gokselozgur5/ar-bot-jimmy/README.md

# Jimmy (`ar-bot-jimmy`) — 38 cm Modular Full-Body ROS 2 + AR Humanoid Companion

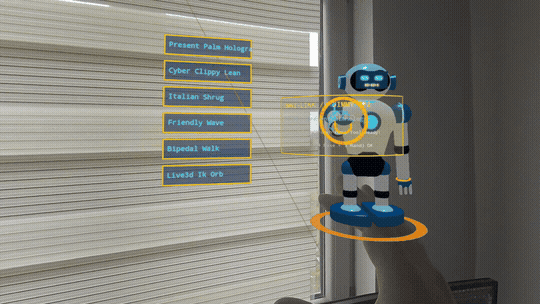
[picture p1: docs/media/quest3_passthrough_live.gif]
Meta Quest 3 Live Passthrough Demo


**Jimmy** is a 38 cm (1.5-span) desktop mini-humanoid companion robot combining **ROS 2 full-body 3-pivot kinematics**, **daisy-chain serial bus actuators**, an **Embodied LLM Puppeteer** (modern Cyber-Clippy persona), and an **OpenXR / Augmented Reality spatial hologram layer**.

## System Architecture

```mermaid
flowchart LR
    LLM["Embodied LLM Puppeteer"] -->|GestureIntent + GazeTarget3D| FK["3-Pivot Full-Body Kinematics"]
    FK -->|SyncWrite IDs 1..14| BUS["Daisy-Chain Serial Servo Bus"]
    BUS -->|Hot-Plug Wrist Socket IDs 15..20| HAND["Modular 3-Finger Hand"]
    FK -->|TF2: right_wrist_flange_link| AR["OpenXR / AR Palm Hologram"]
```

## Subsystem & Phase Matrix

| Phase | Subsystem | Core Artifact | Status |
| :--- | :--- | :--- | :--- |
| **Phase 1** | MBSE & 3-Pivot Kinematics | [`MBSE_MODEL.md`](docs/architecture/MBSE_MODEL.md), [`jimmy_full_body.urdf.xacro`](ros2/jimmy_description/urdf/jimmy_full_body.urdf.xacro), [`kinematics.rs`](crates/jimmy-core/src/kinematics.rs) | Verified |
| **Phase 2** | Serial Bus Servo Bridge | [`bus.rs`](crates/jimmy-core/src/bus.rs) (`ActuatorBus` trait & thermal guard) | Verified |
| **Phase 3** | Embodied LLM Puppeteer | [`puppeteer.rs`](crates/jimmy-core/src/puppeteer.rs) (`CyberClippyLean`, `PresentPalmHologram`) | Verified |
| **Phase 4** | OpenXR / AR Spatial Link | [`ar_anchor.rs`](crates/jimmy-core/src/ar_anchor.rs), [`web/index.html`](web/index.html) (Mass Effect Omni-HUD) | Verified |
| **Phase 5** | Modular 3-Finger Hand | [`hand.rs`](crates/jimmy-core/src/hand.rs) (`ThreeFingerHand` + compliant grasp torque limit) | Verified |
| **Phase 6** | Expressive Visor & 3D Fingers | [`visor-face.js`](web/visor-face.js), [`jimmy-model.js`](web/jimmy-model.js) (Blinking eyes & 3D phalanges) | Verified |
| **Phase 7** | 3-Pivot Inverse Kinematics | [`ik.rs`](crates/jimmy-core/src/ik.rs) (`solve_right_arm_ik` closed-form desk reach solver) | Verified |
| **Phase 8** | Quest 3 3D Laser & Holo-Menu | [`holo-menu.js`](web/holo-menu.js), [`xr-app.js`](web/xr-app.js) (3D spatial menu & controller raycaster) | Verified |
| **Phase 9** | Live LLM Chat & ROS 2 Bridge | [`llm-chat.js`](web/llm-chat.js), [`ros2_bridge.rs`](crates/jimmy-core/src/ros2_bridge.rs) (`Ros2JointState17` `/joint_states`) | Verified |
| **Phase 10** | Telemetry & Control Daemon | [`crates/jimmy-daemon/`](crates/jimmy-daemon/src/main.rs) (`127.0.0.1:8765` live JSON & IK endpoint) | Verified |
| **Phase 11** | Quest 3 Spatial Grab-and-Place | [`spatial-grab.js`](web/spatial-grab.js) (Grip squeeze placement & Desk Anchor Ring) | Verified |
| **Phase 12** | Interactive 3D IK Target Orb | [`ik-target.js`](web/ik-target.js) (Real-time 3-pivot arm & gaze tracking orb) | Verified |
| **Phase 13** | Hardware Harness & Servo ID | [`WIRING_AND_BRINGUP.md`](docs/hardware/WIRING_AND_BRINGUP.md), [`protocol.rs`](crates/jimmy-core/src/protocol.rs) (`encode_set_servo_id`) | Verified |
| **Phase 14** | GitHub Actions CI & Matrix | [`.github/workflows/ci.yml`](.github/workflows/ci.yml) (`13/13` workspace unit tests) | Verified |
| **Phase 15** | Bare-Hand Poke & Desk Placement | [`spatial-grab.js`](web/spatial-grab.js), [`quest3_passthrough_live.gif`](docs/media/quest3_passthrough_live.gif) (Desk placement v3) | Verified |
| **Phase 16** | Rust Watertight STL Exporter | [`cad_export.rs`](crates/jimmy-core/src/cad_export.rs) (`StlBoxSpec::to_ascii_stl` 12-facet solid) | Verified |
| **Phase 17** | 7-Part Printable OpenSCAD & STL | [`cad/scad/`](cad/scad/00_jimmy_full_assembly.scad), [`cad/stl/`](cad/stl/) (7 manifold Prusa-ready `.stl` files) | Verified |
| **Phase 18** | Curved Sci-Fi Body & STL Viewer | [`jimmy-materials.js`](web/jimmy-materials.js), [`jimmy-model.js`](web/jimmy-model.js), [`stl-loader.js`](web/stl-loader.js) | Verified |
| **Phase 19** | Bare-Hand Mirror Teleop Mode | [`hand-teleop.js`](web/hand-teleop.js) (Real-time right arm & 3-finger hand shadowing) | Verified |
| **Phase 20** | Prusa 3D Printing & Slicer Guide | [`3D_PRINTING_GUIDE.md`](docs/hardware/3D_PRINTING_GUIDE.md), [`cad_parts_preview.png`](docs/media/cad_parts_preview.png) | Verified |
| **Phase 21** | Split-Foot Bipedal Kinematics | [`bipedal.rs`](crates/jimmy-core/src/bipedal.rs), [`jimmy_full_body.urdf.xacro`](ros2/jimmy_description/urdf/jimmy_full_body.urdf.xacro) (Level-foot gait & ZMP check) | Verified |
| **Phase 22** | Split-Foot & Leg STL Part Set | [`cad/scad/01a..01d`](cad/scad/01a_left_foot_half_platform.scad), [`cad/stl/01a..01d`](cad/stl/) (4 independent 2-manifold leg/foot STLs) | Verified |
| **Phase 23** | Live WebXR Daemon Telemetry | [`daemon-client.js`](web/daemon-client.js) (`127.0.0.1:8765` live gesture/IK bridge with offline fallback) | Verified |
| **Phase 24** | Spatial Desk Companion HUD | [`desk-widgets.js`](web/desk-widgets.js) (3D 17-Servo load bar graph & 25:00 Pomodoro ring) | Verified |
| **Phase 25** | `v1.0.0` Production Release | [`ASSEMBLY_AND_BOM_V1.md`](docs/hardware/ASSEMBLY_AND_BOM_V1.md), [`.github/workflows/ci.yml`](.github/workflows/ci.yml) (`14/14` workspace tests & 11 STL release assets) | Verified |

## 3D-Printable 11-Part CAD Assembly (`cad/stl/` & `cad/scad/`)

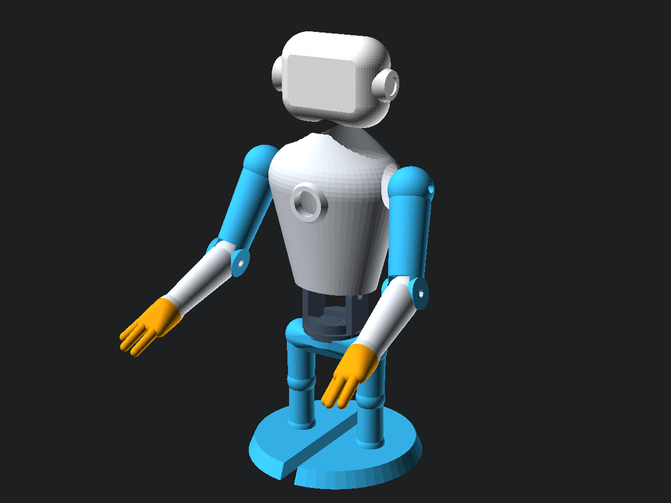
[picture p2: docs/media/cad_parts_preview.png]
Jimmy 3D-Printable CAD Assembly


## Meta Quest 3 WebXR Passthrough & Mass Effect Omni-HUD

Open directly in **Meta Quest 3 Browser** (HTTPS WebXR `immersive-ar`) or desktop browser:
- **Live WebXR App:** `https://gokselozgur5.github.io/ar-bot-jimmy/web/`
- **Local Preview:** `python3 -m http.server 8080 --directory web` (`http://localhost:8080`)

## Hardware & Kinematic Highlights

- **3-Point Spherical Pivots:** 3-DoF Waist (Roll/Pitch/Yaw), 3-DoF Neck/Visor, and Dual 6-DoF Arms (3-pivot shoulder + elbow + 2-DoF wrist socket).
- **Single-Cable Daisy-Chain Bus:** UART/RS-485 smart bus servos (`IDs 1..=14`) eliminate harness clutter and expose a pass-through 3-pin wrist header for plug-and-play finger upgrades (`IDs 15..=20`).
- **Weighted Wheeled-Leg Base:** Battery mass sits inside the wide foot base so aggressive upper-body gestures never tip the robot.

## Verification

```bash
cargo test --workspace
```
