gokselozgur5/ar-bot-jimmy/cad/stl/01d_pelvis_hip_bridge.stl

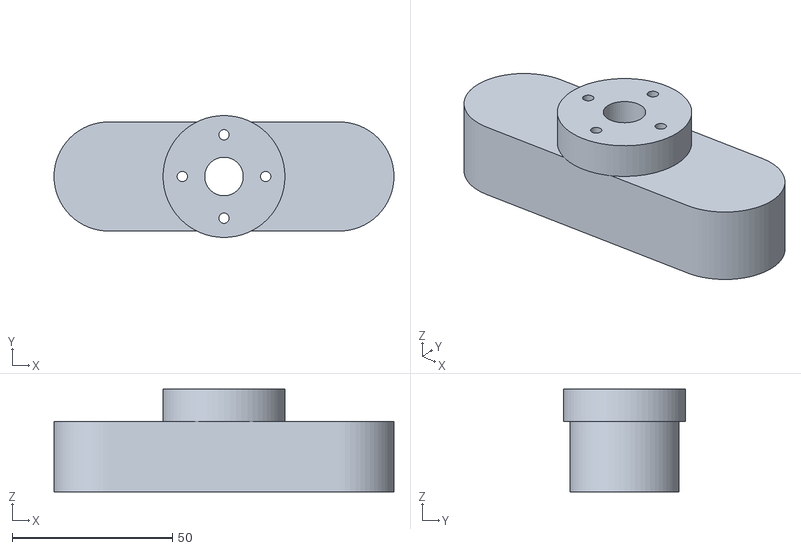
[picture p3: CAD file, 2026-11-05]
cad/stl/01d_pelvis_hip_bridge.stl
106.0 x 38.0 x 32.0
