gokselozgur5/ar-bot-jimmy/cad/stl/01b_right_foot_half_platform.stl

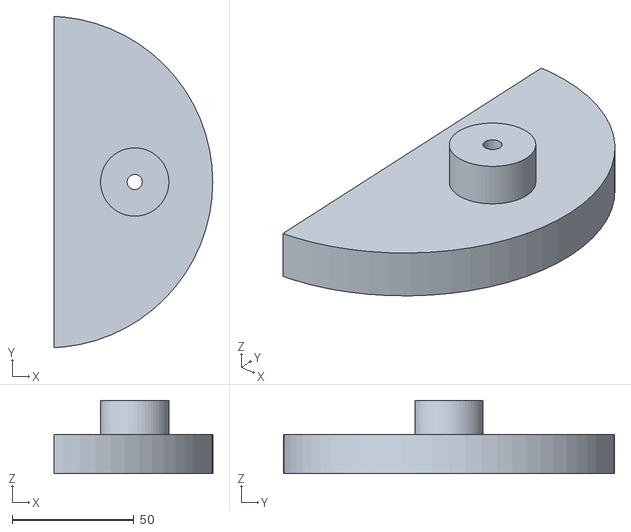
[picture p4: CAD file, 2026-11-05]
cad/stl/01b_right_foot_half_platform.stl
65.0 x 135.7 x 30.0
