gokselozgur5/ar-bot-jimmy/cad/stl/01c_bionic_leg_strut.stl

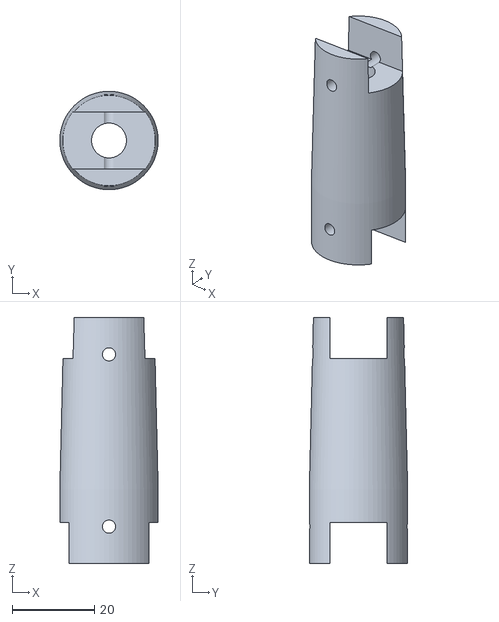
[picture p5: CAD file, 2026-11-05]
cad/stl/01c_bionic_leg_strut.stl
24.0 x 24.0 x 60.0
