gokselozgur5/ar-bot-jimmy/cad/stl/01_wheeled_base_shell.stl

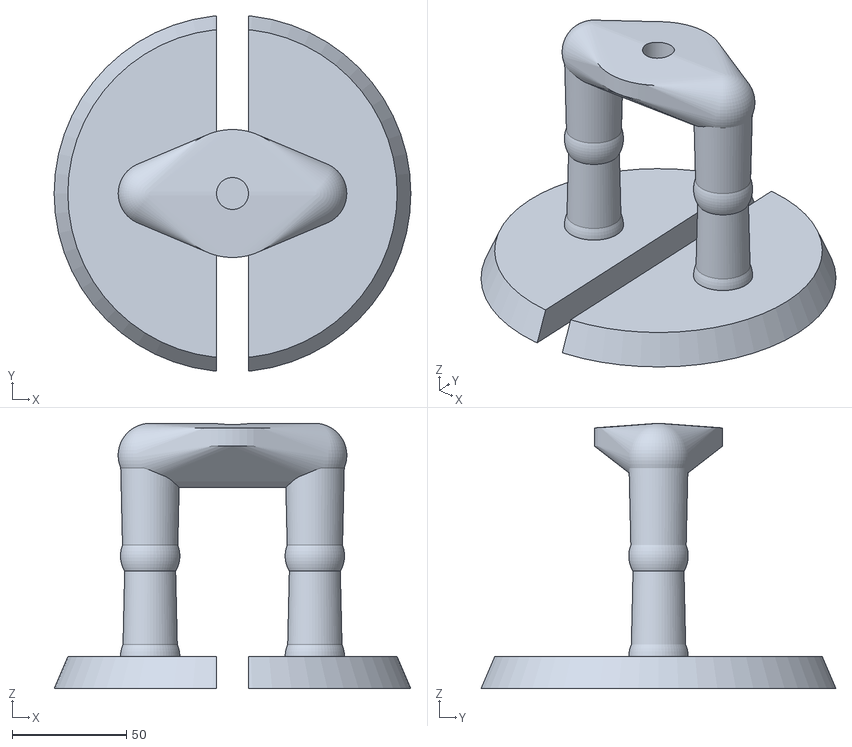
[picture p6: CAD file, 2026-11-05]
cad/stl/01_wheeled_base_shell.stl
156.0 x 155.2 x 116.0
