gokselozgur5/ar-bot-jimmy/cad/stl/02_waist_3pivot_gimbal.stl

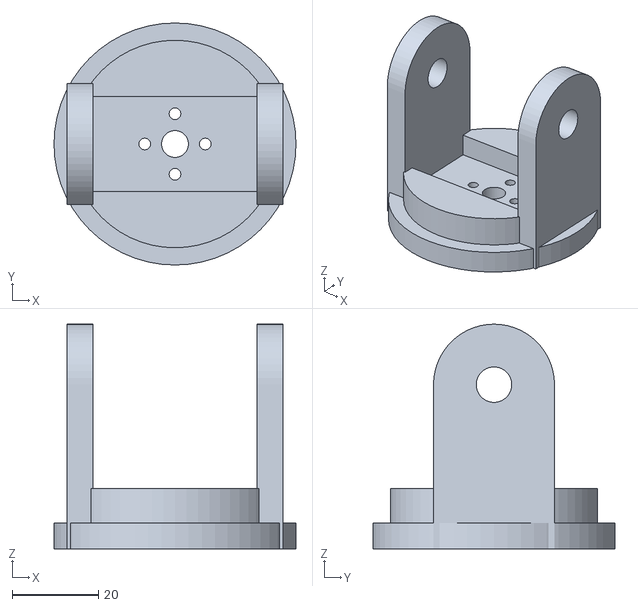
[picture p7: CAD file, 2026-11-05]
cad/stl/02_waist_3pivot_gimbal.stl
56.0 x 56.0 x 52.0
