gokselozgur5/ar-bot-jimmy/cad/stl/06_forearm_wrist_flange.stl

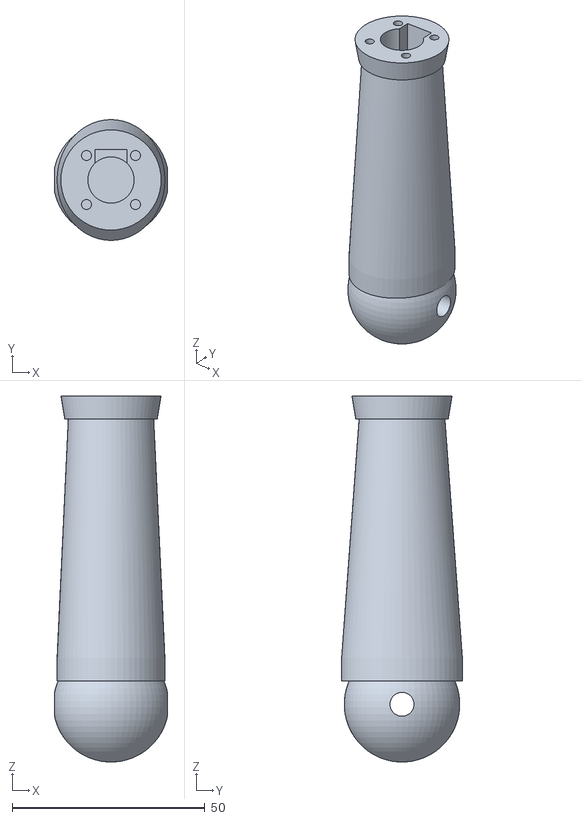
[picture p8: CAD file, 2026-11-05]
cad/stl/06_forearm_wrist_flange.stl
29.3 x 31.4 x 95.0
