gokselozgur5/ar-bot-jimmy/cad/stl/05_upper_arm_bionic_link.stl

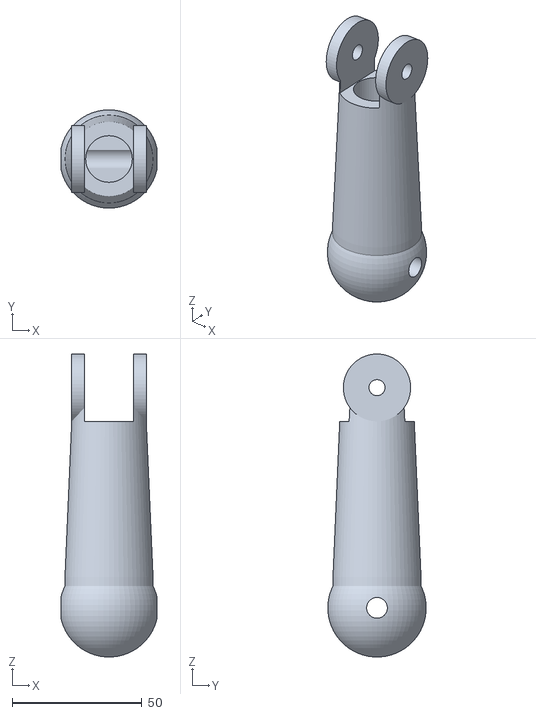
[picture p9: CAD file, 2026-11-05]
cad/stl/05_upper_arm_bionic_link.stl
37.1 x 37.9 x 117.0
