gokselozgur5/ar-bot-jimmy/cad/stl/03_torso_armor_shell.stl

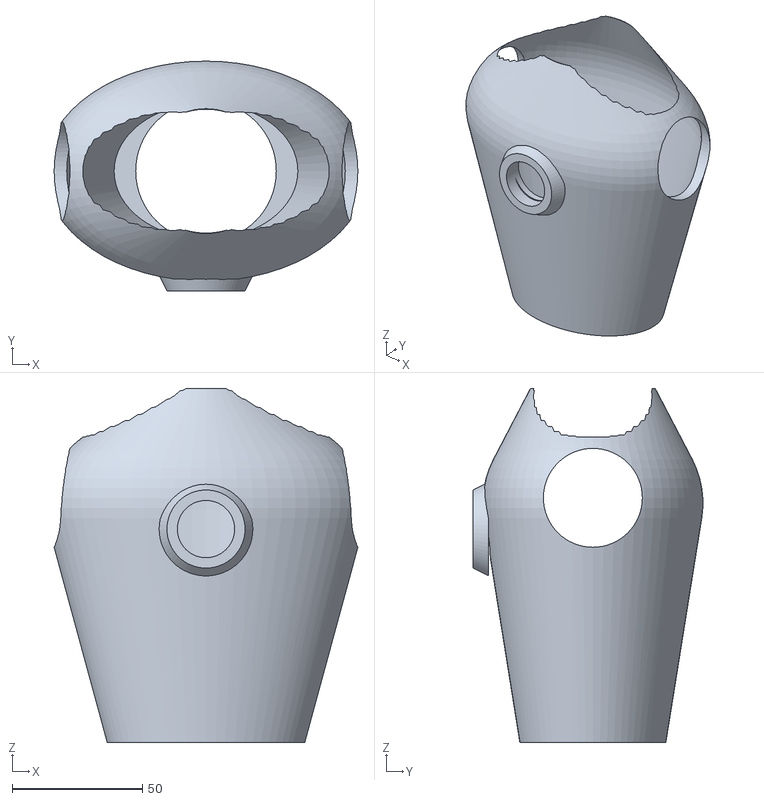
[picture p10: CAD file, 2026-11-05]
cad/stl/03_torso_armor_shell.stl
116.7 x 88.3 x 136.0
