gokselozgur5/ar-bot-jimmy/cad/stl/04_cyber_clippy_head_visor.stl

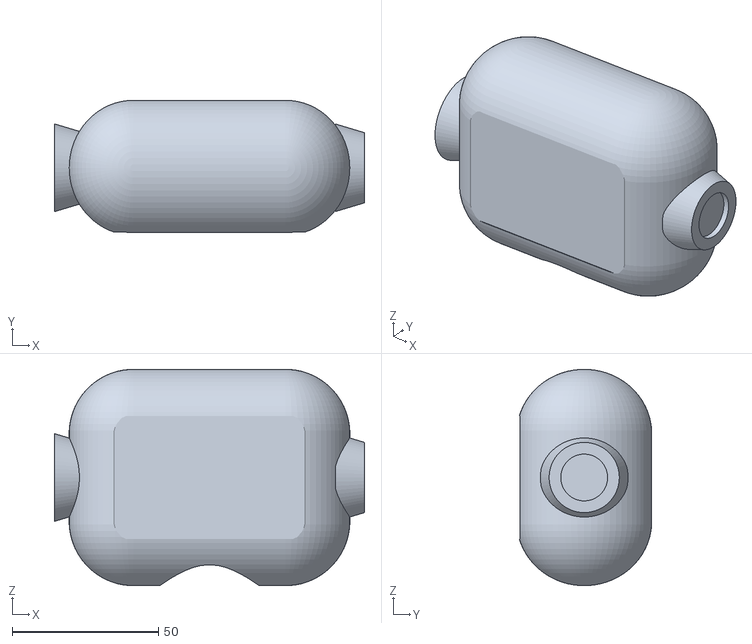
[picture p11: CAD file, 2026-11-05]
cad/stl/04_cyber_clippy_head_visor.stl
106.0 x 45.3 x 73.9
