gokselozgur5/ar-bot-jimmy/cad/stl/07_modular_3finger_hand.stl

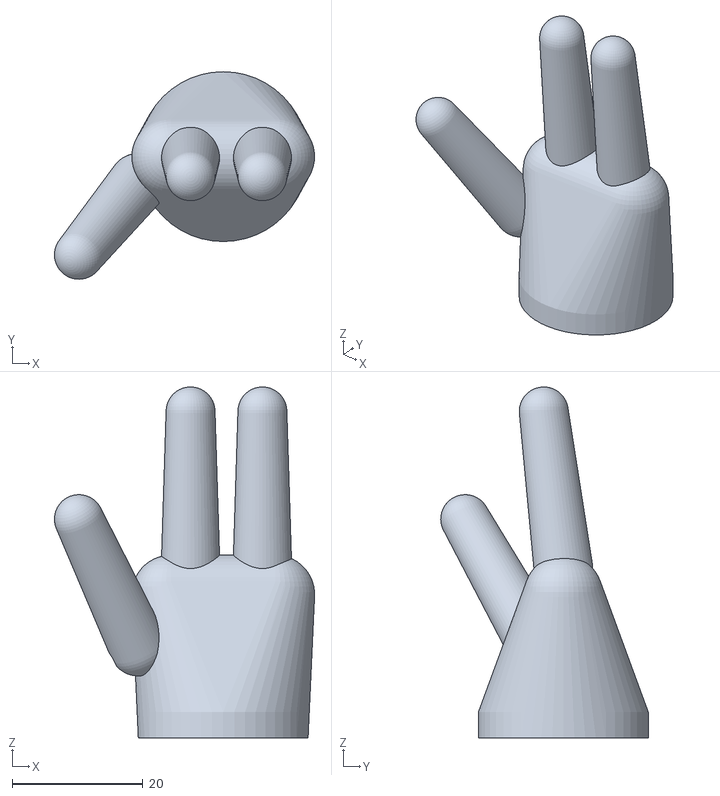
[picture p12: CAD file, 2026-11-05]
cad/stl/07_modular_3finger_hand.stl
39.8 x 31.8 x 53.7
