gokselozgur5/ar-bot-jimmy/(list of files, cad)

Other CAD files:
cad/stl/01a_left_foot_half_platform.stl
cad/scad/01b_right_foot_half_platform.scad
