gokselozgur5/ar-bot-jimmy/(commit log)

2026-11-04 feat(urdf): add modular Xacro skeleton with 3-pivot joints (#1)
    [jimmy_full_body.urdf.xacro]
2026-11-04 feat(kinematics): add 3-pivot full-body pose and right wrist FK (#1)
2026-11-04 test(kinematics): verify forward kinematics palm elevation (#1)
2026-11-04 feat(bus): define ActuatorBus trait and SimDaisyChainBus (#2)
2026-11-04 test(bus): verify 14-DoF daisy-chain discovery and sync_write (#2)
2026-11-04 feat(ar-openxr): add SpatialHologramAnchor bound to wrist TF2 frame (#4)
2026-11-04 test(hand): wire hand module and verify hot-plug servos 15-17 (#5)
2026-11-04 docs(roadmap): add 5-phase engineering roadmap and hardware BOM (#17)
2026-11-04 feat(webxr): add 3D 38cm articulated Jimmy humanoid mesh (#15)
2026-11-04 feat(webxr): wire Three.js WebXR passthrough loop and 3-pivot interpolation (#15)
2026-11-04 docs(cad): add 380mm 3D-printable shell and 6700ZZ bearing tolerances (#12)
2026-11-04 feat(bus): add set_simulated_load helper for contact torque testing (#16)
2026-11-04 feat(hand): implement command_compliant_grasp torque cutoff (#16)
2026-11-04 test(hand): verify compliant grasp halts finger on contact load (#16)
2026-11-05 feat(ik): add closed-form 3-pivot right arm Inverse Kinematics solver (#32)
2026-11-05 test(ik): verify analytical IK against forward kinematics wrist position (#32)
2026-11-05 test(ik): use reachable 16.5cm arm envelope target in IK unit test (#32)
2026-11-05 feat(webxr): add 3D articulated 3-finger hand phalanges and visor plane (#31)
2026-11-05 feat(webxr): add 3D floating Mass Effect holo-menu and controller laser (#33)
2026-11-05 feat(webxr): wire 3D laser raycasting, visor animation, and finger grasp (#33)
2026-11-05 feat(ros2): add 17-DoF JointState rosbridge v2 JSON serializer (#40)
2026-11-05 test(ros2): verify 17-DoF /joint_states rosbridge v2 payload (#40)
2026-11-05 feat(webxr): wire live TR/EN chat box and mic button into Omni-HUD (#40)
2026-11-05 feat(xr): wire spatial grab-and-place into WebXR animation loop
2026-11-05 feat(xr): wire 3D IK target orb toggle into WebXR HUD and loop
2026-11-05 feat(protocol): add STS3215 EEPROM REG_ID write packet encoder
2026-11-05 test(protocol): verify STS3215 servo ID provisioning frame and CRC
2026-11-05 docs(hardware): add 12V-to-7.4V power budget and daisy-chain bring-up guide
2026-11-05 feat(xr): add bare-hand index-finger poke and pinch-hold grab support
2026-11-05 feat(xr): enable WebXR hand-tracking and 5th Live3dIkOrb holo-button
2026-11-05 feat(xr): enlarge 3D Holo-Menu button hit planes for hand raycasting
2026-11-05 feat(cad): add parametric watertight ASCII STL mesh generator in jimmy-core
2026-11-05 test(cad): verify 12-facet manifold STL export for STS3215 servo bracket
2026-11-05 feat(cad): add OpenSCAD wheeled base and 3-pivot waist gimbal brackets
    [01_wheeled_base_shell.scad, 02_waist_3pivot_gimbal.scad]
2026-11-05 feat(cad): add OpenSCAD sculpted torso carapace and curved head visor shell
    [03_torso_armor_shell.scad, 04_cyber_clippy_head_visor.scad]
2026-11-05 feat(cad): add OpenSCAD bionic arm links, wrist flange, and 3-finger hand
    [00_jimmy_full_assembly.scad, 05_upper_arm_bionic_link.scad, 06_forearm_wrist_flange.scad, 07_modular_3finger_hand.scad]
2026-11-05 build(cad): compile 7 manifold 3D-printable STL meshes for PrusaSlicer
    [01_wheeled_base_shell.stl, 02_waist_3pivot_gimbal.stl, 03_torso_armor_shell.stl, 04_cyber_clippy_head_visor.stl, 05_upper_arm_bionic_link.stl, 06_forearm_wrist_flange.stl, 07_modular_3finger_hand.stl]
2026-11-05 feat(xr): add PBR clearcoat armor materials and curved head/base builders
2026-11-05 feat(xr): replace boxy primitives with sculpted Astro-Bot/EVE curved chassis
2026-11-05 feat(xr): add Three.js STLLoader overlay for 3D-printable CAD shells
2026-11-05 feat(xr): wire CAD STL wireframe and Hand Teleop buttons into HUD
2026-11-05 docs(cad): add PrusaSlicer 3D printing and Blender customization guide
2026-11-05 ci(actions): verify 7 printable STL meshes and 13/13 workspace tests
2026-11-05 docs(readme): embed 3D-printable CAD assembly render and Phases 15-20
2026-11-05 fix(xr): replace STLLoader addon with zero-dep ASCII STL parser
2026-11-05 fix(xr): add three importmap, inline dark theme, and 2-col button grid
2026-11-05 fix(xr): use MeshStandardMaterial and ?v=4 import on curved sci-fi chassis
2026-11-05 feat(xr): build split D-shaped half-platform feet and articulated legs
2026-11-05 feat(cad): update Part 01 OpenSCAD and STL to split-platform bipedal feet
    [00_jimmy_full_assembly.scad, 01_wheeled_base_shell.scad, 01_wheeled_base_shell.stl]
2026-11-05 feat(core): add split-platform bipedal leg kinematics and ZMP check (#76)
2026-11-05 feat(urdf): add left and right split-platform foot links and joints (#76)
    [jimmy_full_body.urdf.xacro]
2026-11-05 feat(cad): add 01a left split D-shaped half-platform foot SCAD and STL (#77)
    [01a_left_foot_half_platform.scad, 01a_left_foot_half_platform.stl]
2026-11-05 feat(cad): add 01b right split D-shaped half-platform foot SCAD and STL (#77)
    [01b_right_foot_half_platform.scad, 01b_right_foot_half_platform.stl]
2026-11-05 feat(cad): add 01c articulated bionic leg strut SCAD and STL (#77)
    [01c_bionic_leg_strut.scad, 01c_bionic_leg_strut.stl]
2026-11-05 feat(cad): add 01d pelvis hip bridge SCAD and STL (#77)
    [01d_pelvis_hip_bridge.scad, 01d_pelvis_hip_bridge.stl]
2026-11-05 feat(web): add 3D Mass Effect servo load HUD and Pomodoro desk widget (#79)
2026-11-05 feat(web): wire Desk HUD toggle button and bump cache-buster to v6 (#79)
2026-11-05 docs(hardware): add v1.0.0 full assembly manual and 11-part STL BOM (#80)
2026-11-05 ci: enforce 14/14 workspace tests and 11 printable STL CAD assets (#80)
